nnaumenko/webconfig-ESP8266-tempmon/hardware/esp8266_temp_monitor.pdf

JP2 123

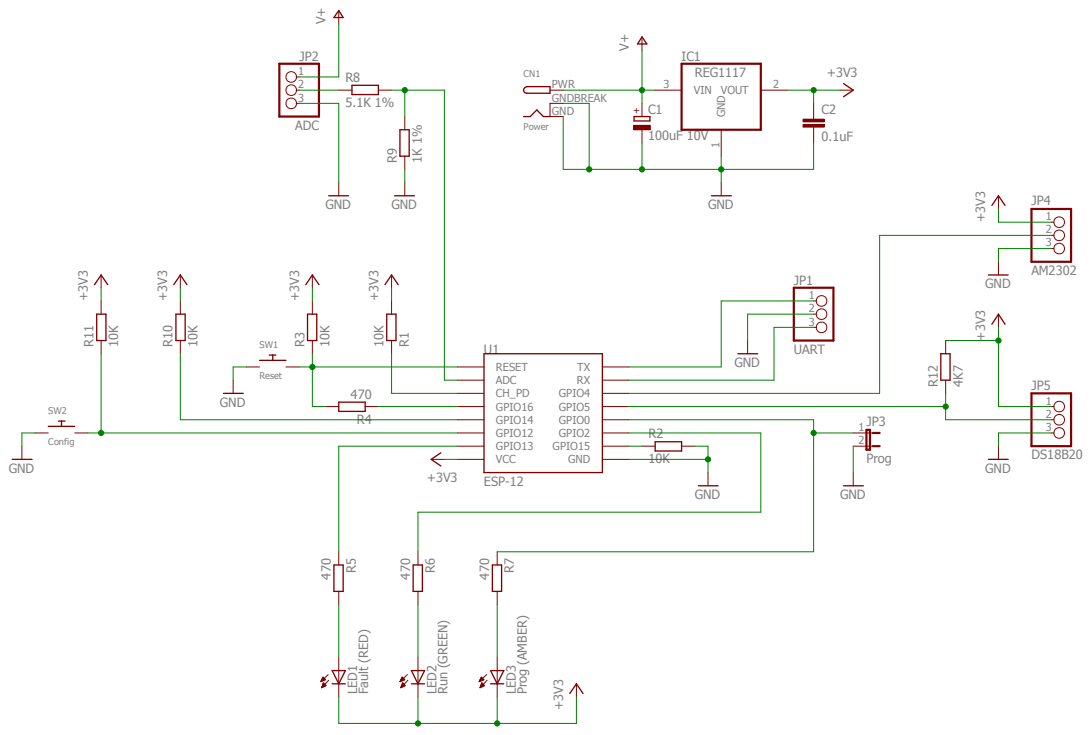
[picture p1: page 1]
