nnaumenko/webconfig-ESP8266-tempmon/hardware/esp8266_temp_monitor.sch

## EAGLE design hardware/esp8266_temp_monitor.sch (2016-01-27)

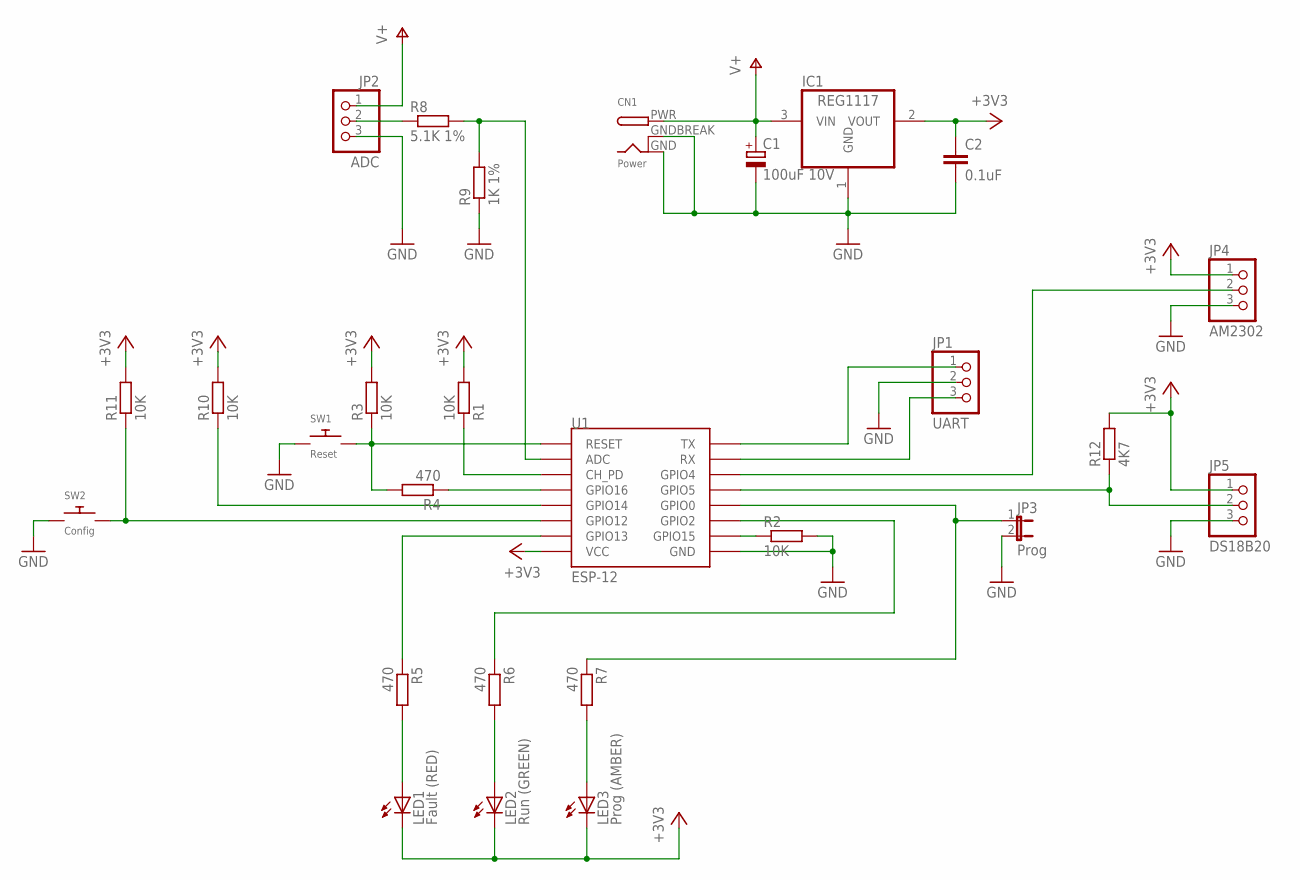
[picture p2: schematic esp8266_temp_monitor.sch]

Parts:
C1: 100uF 10V; E/7260-38W
C2: 0.1uF; C0805
CN1: Power; DCJACK_2MM_PTH
IC1: REG1117; SOT223
JP1: UART; 1X03
JP2: ADC; 1X03
JP3: Prog; JP1
JP4: AM2302; 1X03
JP5: DS18B20; 1X03
LED1: Fault (RED); LED5MM
LED2: Run (GREEN); LED5MM
LED3: Prog (AMBER); LED5MM
R1, R2: 10K; R0805
R3, R10, R11: 10K; M0805
R4, R5, R6, R7: 470; M0805
R8: 5.1K 1%; M0805
R9: 1K 1%; M0805
R12: 4K7; M0805
SW1: Reset; BTN_CK_KSS
SW2: Config; BTN_CK_KSS
U1: ESP-12; ESP12-SMD

Connections:
+3V3: C2.1, IC1.2 (VOUT), JP4.1, JP5.1, LED1.K (C), LED2.K (C), LED3.K (C), R1.2, R3.2, R10.2, R11.2, R12.2, U1.VCC
ADC_1V: R8.2, R9.2, U1.ADC
ADC_RAW: JP2.2, R8.1
CH_PD: R1.1, U1.CH_PD
GND: C1.-, C2.2, CN1.GND, CN1.GNDBREAK, IC1.1 (GND), JP1.2, JP2.3, JP3.2, JP4.3, JP5.3, R2.2, R9.1, SW1.P$1, SW2.P$1, U1.GND
GPIO0: JP3.1, R7.1, U1.GPIO0
GPIO2: R6.1, U1.GPIO2
GPIO4: JP4.2, U1.GPIO4
GPIO5: JP5.2, R12.1, U1.GPIO5
GPIO13: R5.1, U1.GPIO13
LED_FAULT: LED1.A, R5.2
LED_OPERATE: LED2.A, R6.2
LED_PROG: LED3.A, R7.2
unnamed: R4.1, U1.GPIO16
unnamed: R2.1, U1.GPIO15
unnamed: R10.1, U1.GPIO14
unnamed: R11.1, SW2.P$2, U1.GPIO12
RESET: R3.1, R4.2, SW1.P$2, U1.RESET
RXD: JP1.3, U1.RXD0 (RX)
TXD: JP1.1, U1.TXD0 (TX)
V+: C1.+, CN1.PWR, IC1.3 (VIN), JP2.1
