nnaumenko/webconfig-ESP8266-tempmon/(commit log)

2016-01-27 Fixed minor circuit diagram error
    Modified LED description
    [esp8266_temp_monitor.sch]
2016-07-29 Minor improvements
    * Minor memory & stability improvements
    * Changed update timings to reduce load on Blynk server
    * Binary file added to the project
    [temp_monitor_esp8266.ino, web_content.cpp, webconfig.cpp]
